suapapa/HUMA/.impeccable/surfaces/site.md

---
version: 1
slug: "site"
primary_target: "site"
related_targets: ["site/index.html","site/huma_bom.html"]
---

# Surface: site assembly docs

Mode: Read
Audience: makers assembling HUMA at the workbench
Job: follow Korean assembly steps and BOM without getting lost
Quality bar: Adafruit Learn, SparkFun tutorials

## Direction contract

THESIS: Clean open-hardware tutorial docs. Frame and column serve the guide; refuse poster/landing hero theatrics.
OWN-WORLD: Cool paper ground, charcoal text, one solder-amber accent for warnings and active nav; Pretendard/Noto reading face; hairline tables; photo figures as checkpoints.
STORY: Reader knows this is the HUMA assembly guide, finds TOC and first step, trusts warnings and BOM links.
FIRST VIEWPORT: Sticky top nav (HUMA / 조립 / 부품 / GitHub). Title + short intro left, PCB photo right. Warning callout. Inline contents. Primary action: start 도구 및 준비물.
FORM: Category-standard clean docs (canon), seed 62ff8e49 safer register; Adafruit Learn / SparkFun craft bar.
FINISH: unreviewed and undocumented is unfinished; this build ends with the finish review, the verdict, DESIGN.md, and every shipping raster carrying its provenance
