suapapa/HUMA/export/HUMA_sch.png

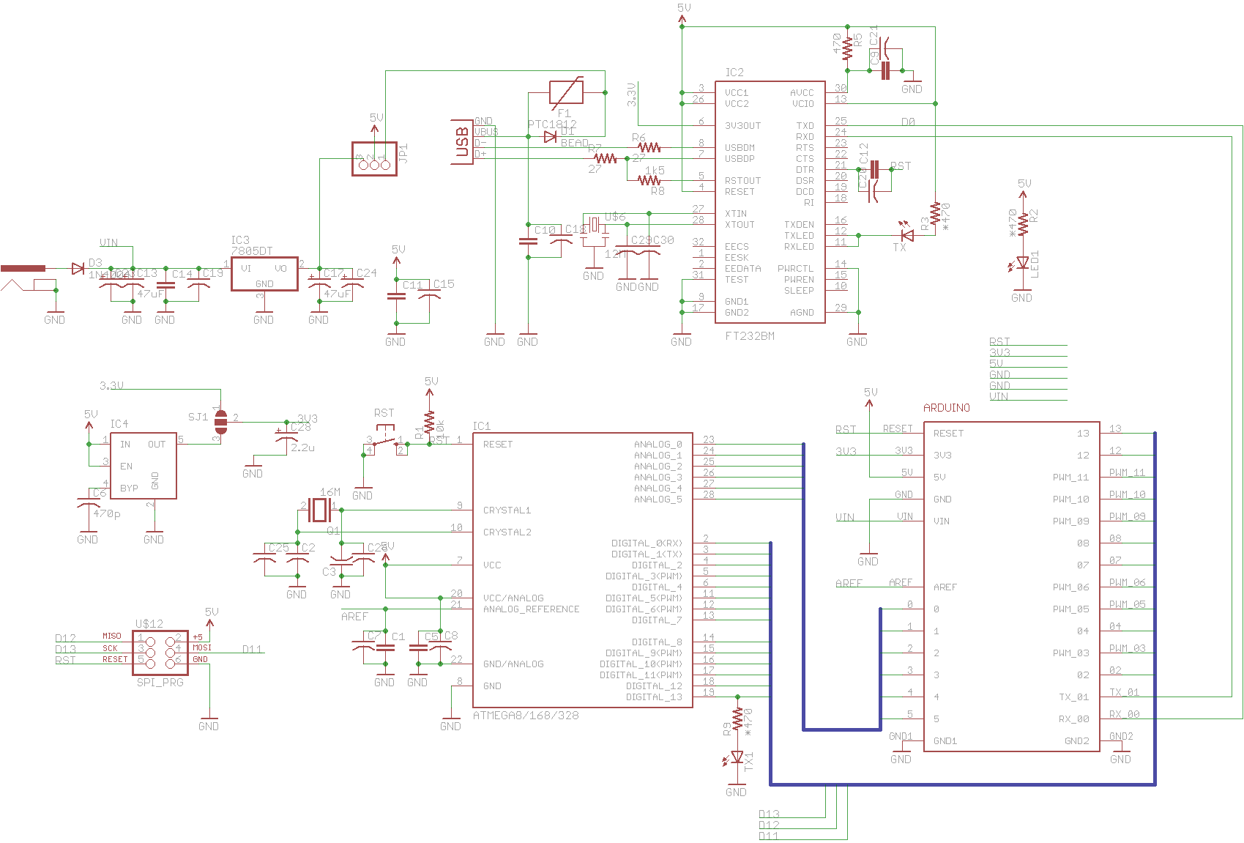
export/HUMA_sch.png
