suapapa/HUMA/site/og-image.png

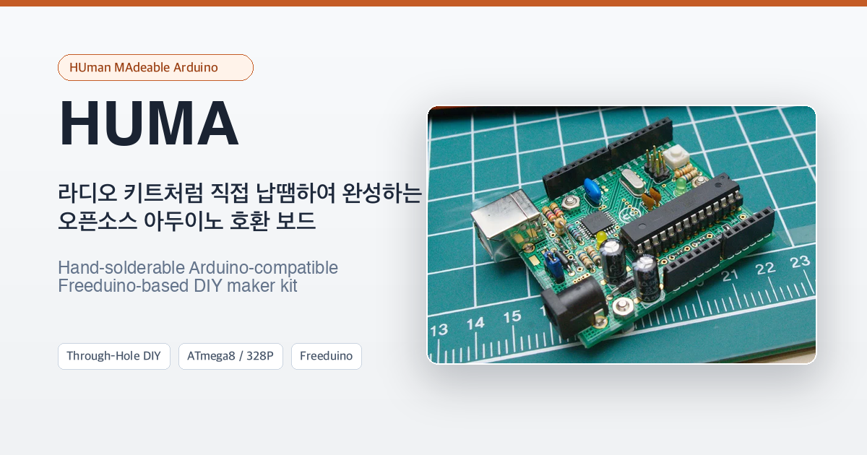
site/og-image.png
