suapapa/HUMA/site/pics/00_tools.webp

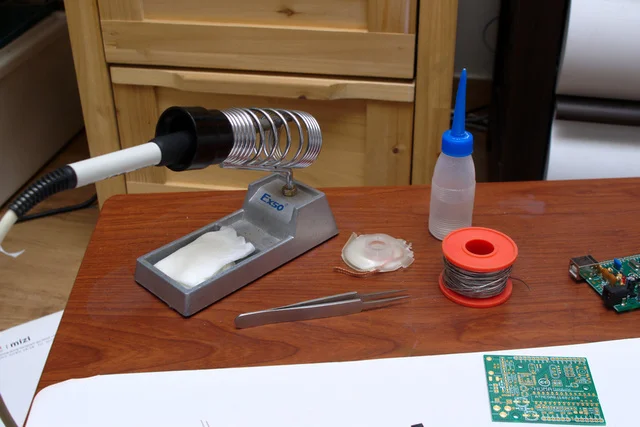
site/pics/00_tools.webp
