suapapa/HUMA/site/pics/HUMA_pcb.webp

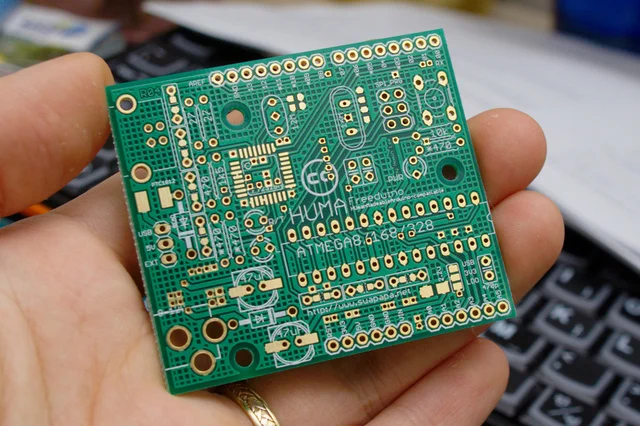
site/pics/HUMA_pcb.webp
