suapapa/HUMA/doc/pics/15_order_arduinos.jpg

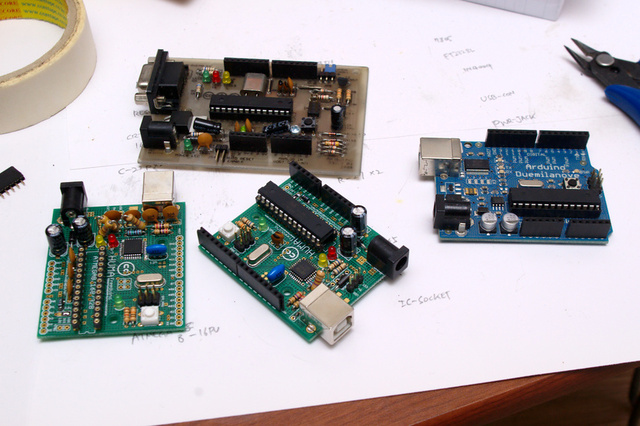
doc/pics/15_order_arduinos.jpg
