suapapa/HUMA/site/pics/00_check_parts.webp

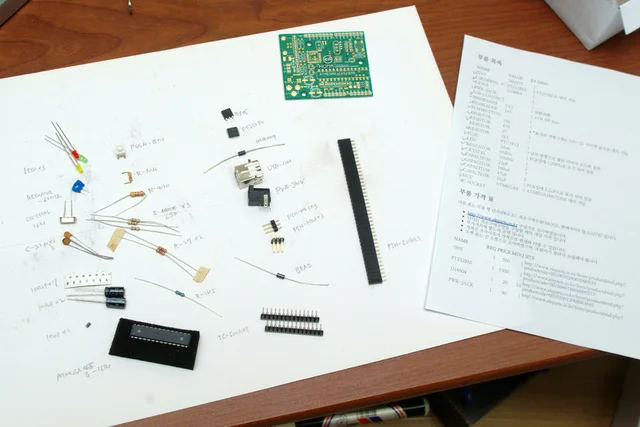
site/pics/00_check_parts.webp
