suapapa/HUMA/site/pics/03_solder_lead_parts.webp

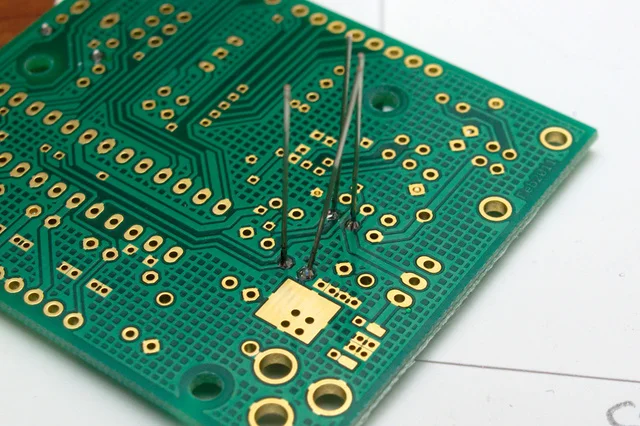
site/pics/03_solder_lead_parts.webp
