suapapa/HUMA/site/pics/04_solder_lead_parts.webp

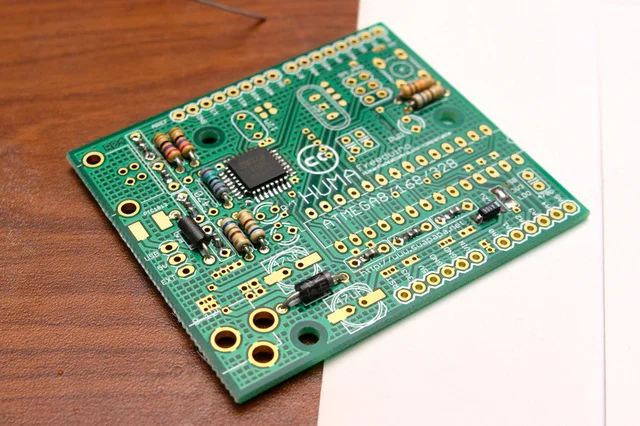
site/pics/04_solder_lead_parts.webp
