suapapa/HUMA/(commit log)

2011-02-27 eagle: add eaglecad files
    [HUMA.brd, HUMA.sch]
2011-02-28 gerber_conf: added gerber related files
    [layout2.cfg]
2011-07-29 eagle: clean up sch and brd
    - deleted unused parts
    - added 1k ohm in RX/TX lines
    [HUMA.brd, HUMA.sch]
2011-08-01 eagle: clean routing
    [HUMA.brd]
2011-08-02 eagle: added solder jumper to RX/TX
    [HUMA.brd, HUMA.sch]
2011-08-17 eagle: fixed non 45-degrees routings
    [HUMA.brd]
2011-09-07 eagle: added non-smd 7805
    [HUMA.brd, HUMA.sch]
2011-11-09 eagle: added more components
    [HUMA.brd, HUMA.sch]
2011-11-10 eagle: squash trace gaps
    [HUMA.brd, HUMA.sch]
2011-11-10 eagle: added addtional pinheader for breadboard
    [HUMA.brd, HUMA.sch]
2011-11-11 eagle: finetune traces
    [HUMA.brd]
2011-11-14 eagle: fine tuned traces
    [HUMA.brd, HUMA.sch]
2011-11-30 eagle: finetune silk
    [HUMA.brd, HUMA.sch]
2011-12-01 eagle: tine tune vias
    [HUMA.brd]
2011-12-01 export: added exported gerber of HUMA R04
2011-12-01 eagle: fixed revision in board to R05
    [HUMA.brd]
2011-12-01 export: update exported gerber
2011-12-13 doc: added 1k ohm in BOM
